dulnith-liyanage/EcoSort_Smart_Bin/assets/ecosort_prototype_hero.jpg

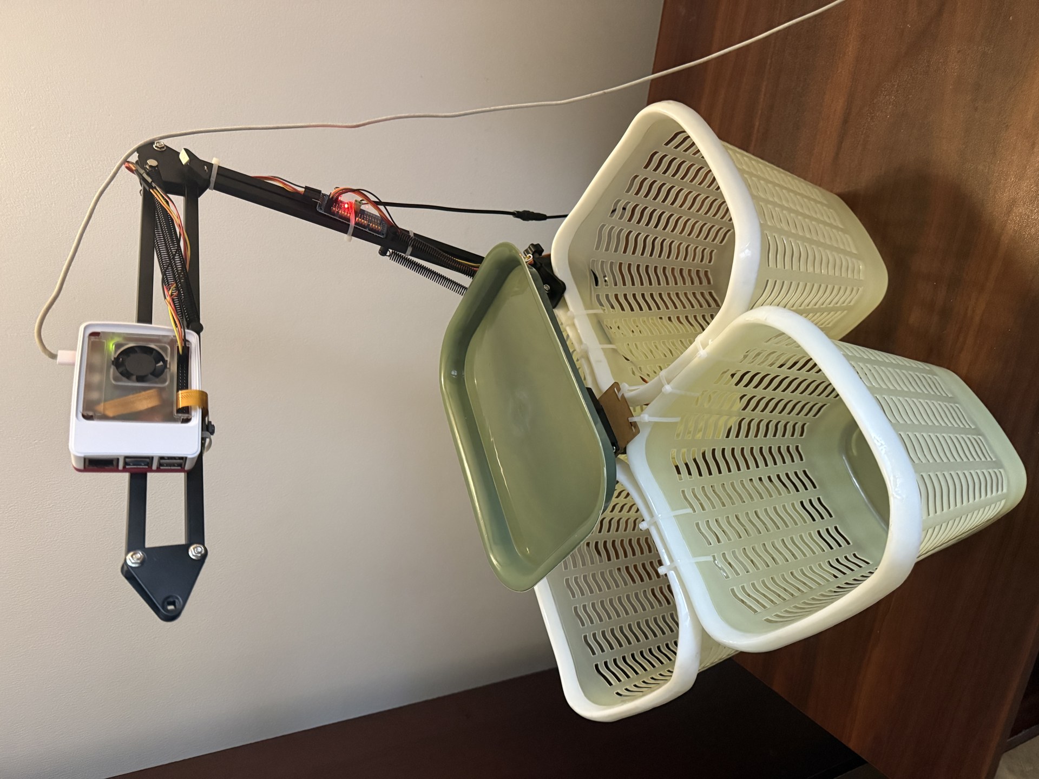
assets/ecosort_prototype_hero.jpg
