dulnith-liyanage/EcoSort_Smart_Bin/images/FMUD5077.jpg

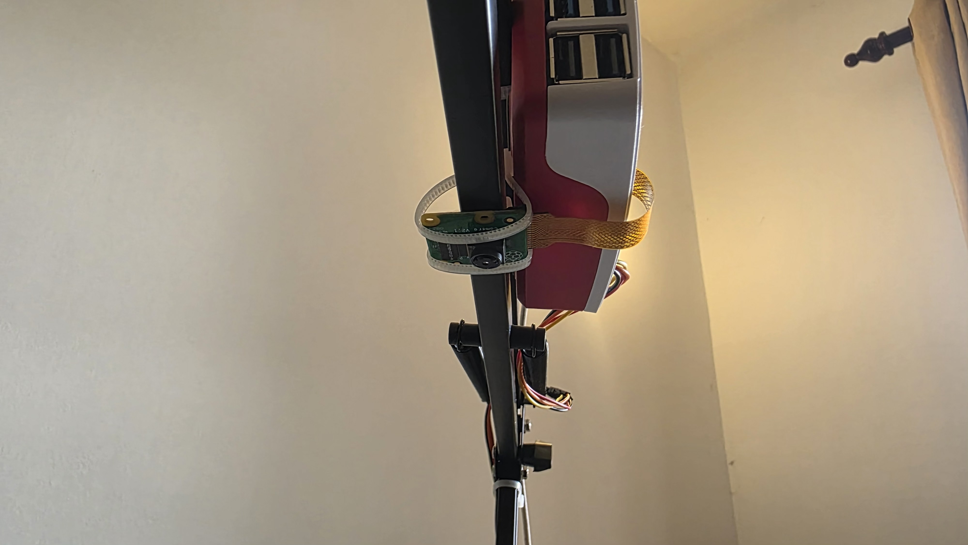
images/FMUD5077.jpg
