dulnith-liyanage/EcoSort_Smart_Bin/hardware/design/output/complete_assembly.step

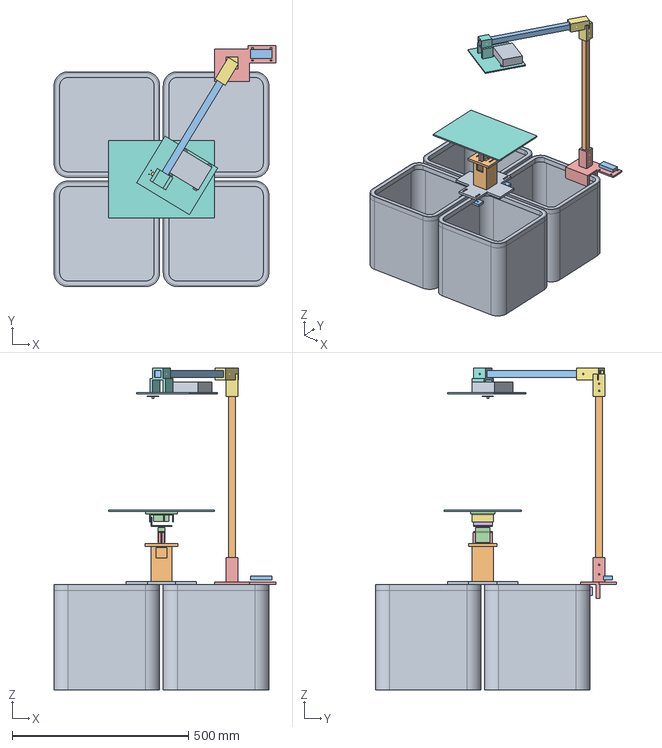
[picture p11: CAD file, 2026-10-23]
hardware/design/output/complete_assembly.step
630.0 x 685.0 x 914.0 mm
