dulnith-liyanage/EcoSort_Smart_Bin/hardware/motor_assembly_only/EcoSort_motor_assembly.step

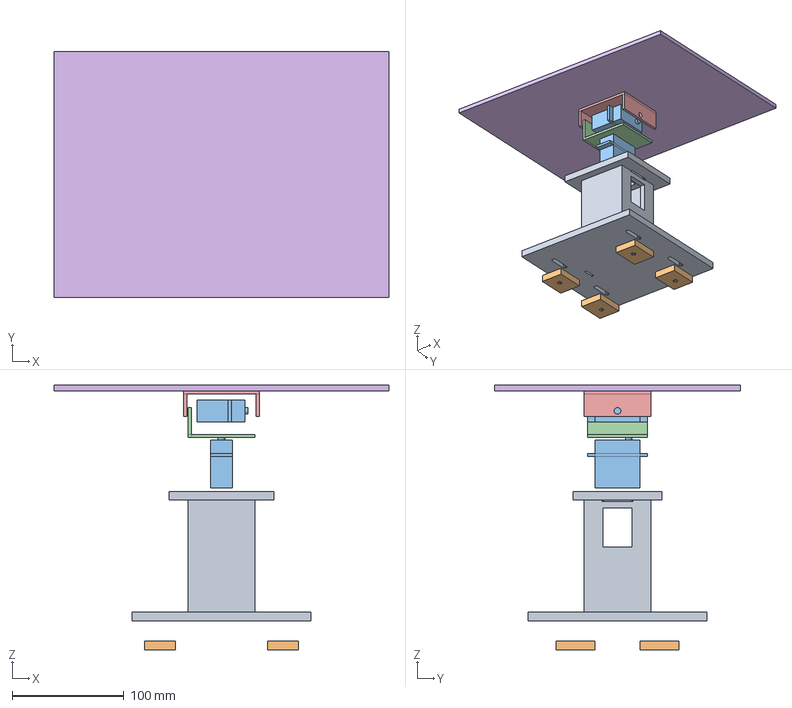
[picture p12: CAD file, 2026-10-20]
hardware/motor_assembly_only/EcoSort_motor_assembly.step
300.0 x 220.0 x 237.0 mm
