dulnith-liyanage/EcoSort_Smart_Bin/hardware/design/output/motor_assembly.step

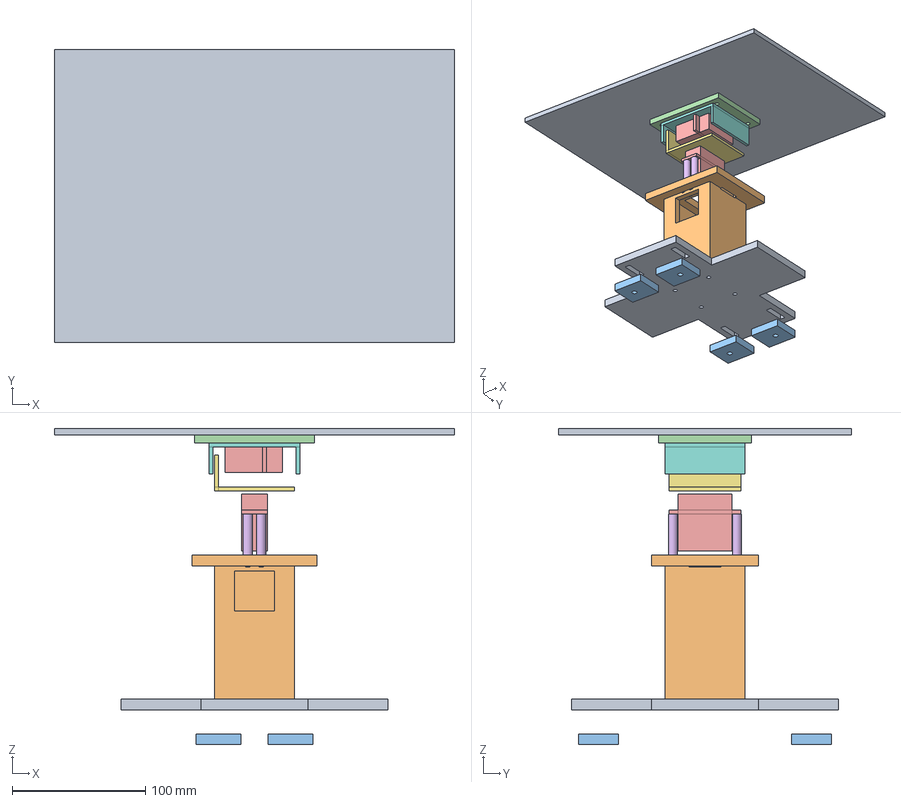
[picture p13: CAD file, 2026-10-23]
hardware/design/output/motor_assembly.step
300.0 x 220.0 x 237.0 mm
