dulnith-liyanage/EcoSort_Smart_Bin/hardware/design/output/step/01_cross_base.step

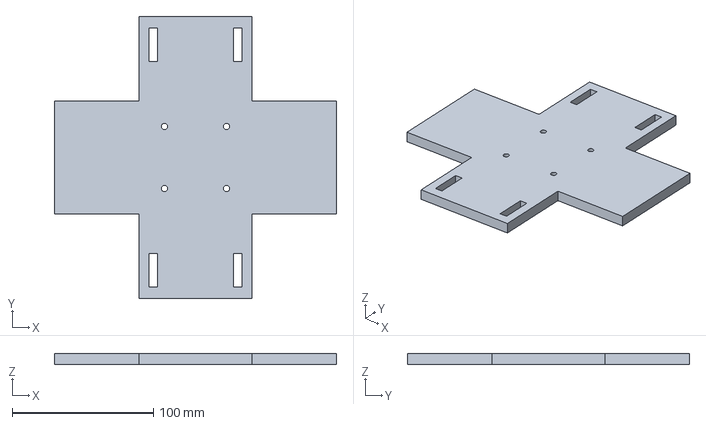
[picture p14: CAD file, 2026-10-23]
hardware/design/output/step/01_cross_base.step
200.0 x 200.0 x 8.00 mm
