dulnith-liyanage/EcoSort_Smart_Bin/hardware/simple_mount_v4/motor_mount.step

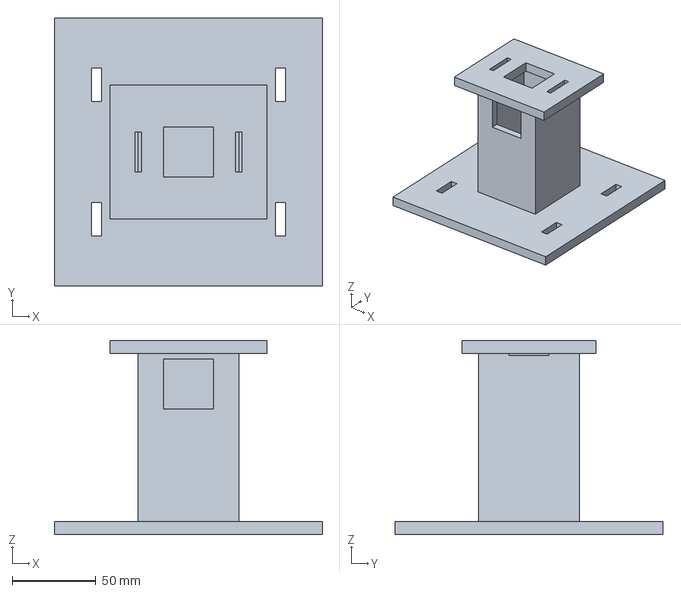
[picture p15: CAD file, 2026-10-20]
hardware/simple_mount_v4/motor_mount.step
160.0 x 160.0 x 116.0 mm
