dulnith-liyanage/EcoSort_Smart_Bin/hardware/design/output/step/07_timber_elbow.step

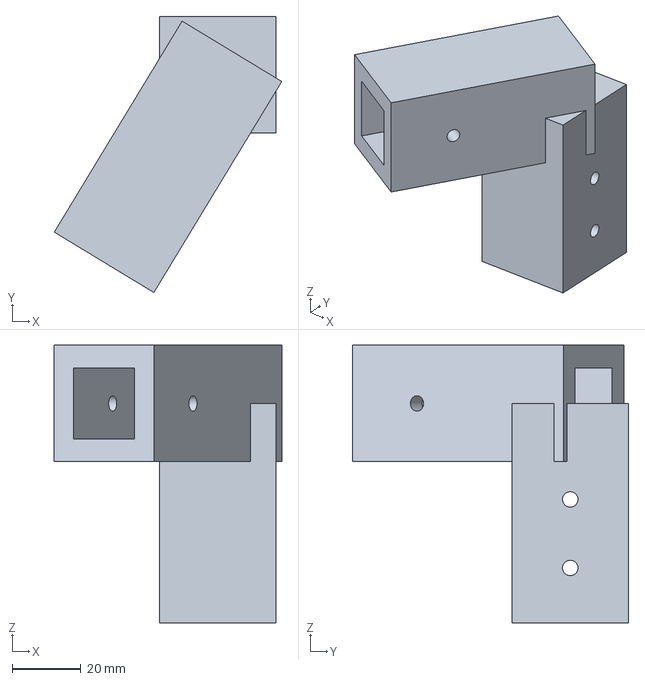
[picture p16: CAD file, 2026-10-23]
hardware/design/output/step/07_timber_elbow.step
66.4 x 80.5 x 81.0 mm
