dulnith-liyanage/EcoSort_Smart_Bin/hardware/simple_mount_v4/optional_rim_shoe.step

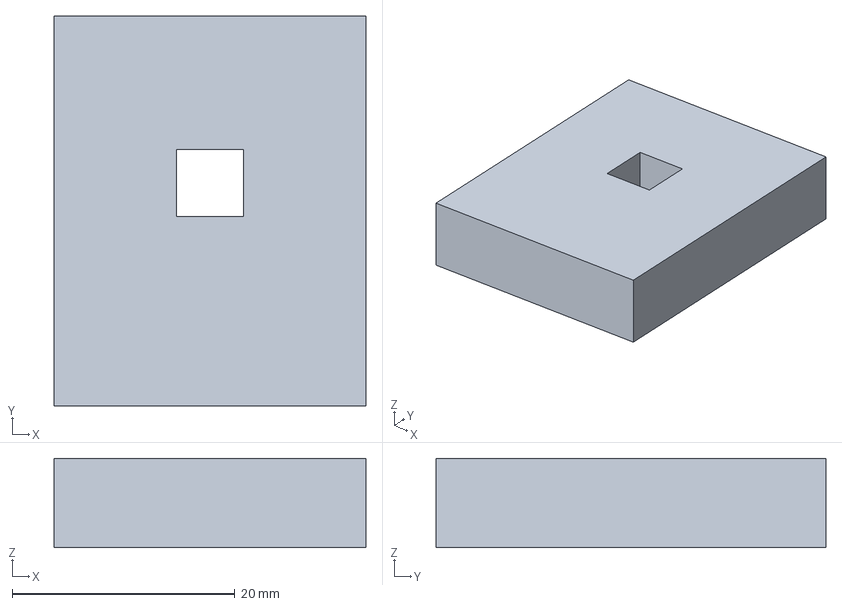
[picture p17: CAD file, 2026-10-20]
hardware/simple_mount_v4/optional_rim_shoe.step
28.0 x 35.0 x 8.00 mm
