dulnith-liyanage/EcoSort_Smart_Bin/hardware/design/output/step/02_motor_pedestal.step

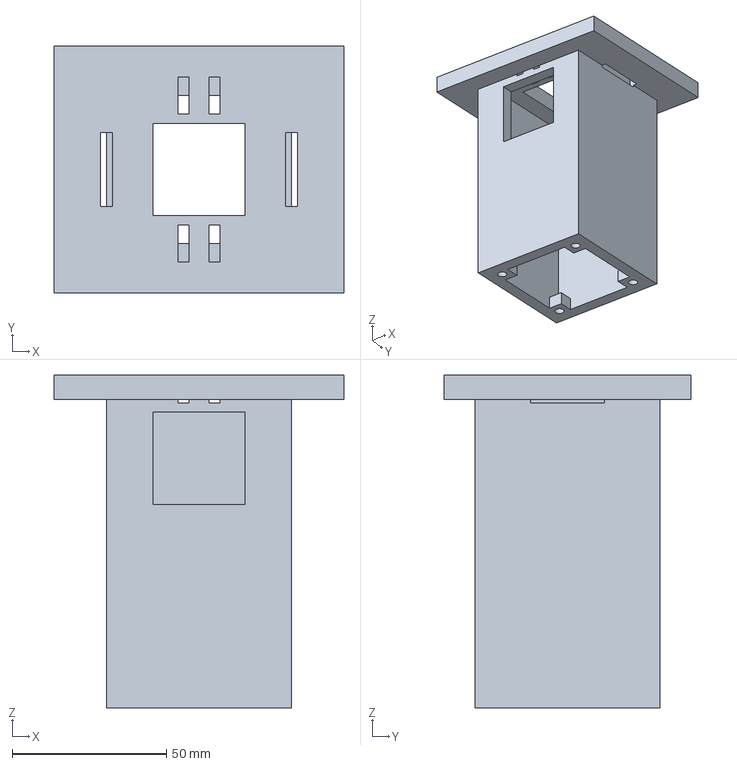
[picture p18: CAD file, 2026-10-23]
hardware/design/output/step/02_motor_pedestal.step
94.0 x 80.0 x 108.0 mm
