dulnith-liyanage/EcoSort_Smart_Bin/hardware/design/output/step/09_rim_and_timber_fit_coupon.step

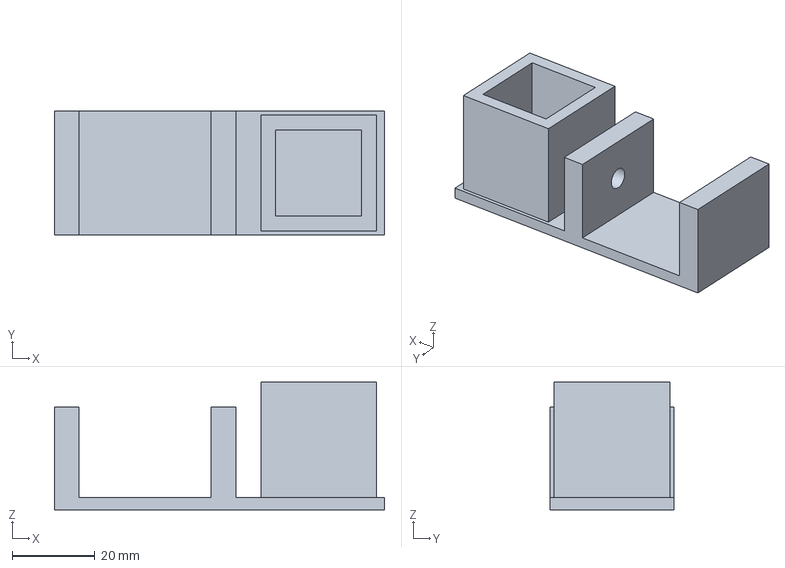
[picture p19: CAD file, 2026-10-23]
hardware/design/output/step/09_rim_and_timber_fit_coupon.step
80.0 x 30.0 x 31.0 mm
