dulnith-liyanage/EcoSort_Smart_Bin/hardware/design/output/step/06_pressure_pad.step

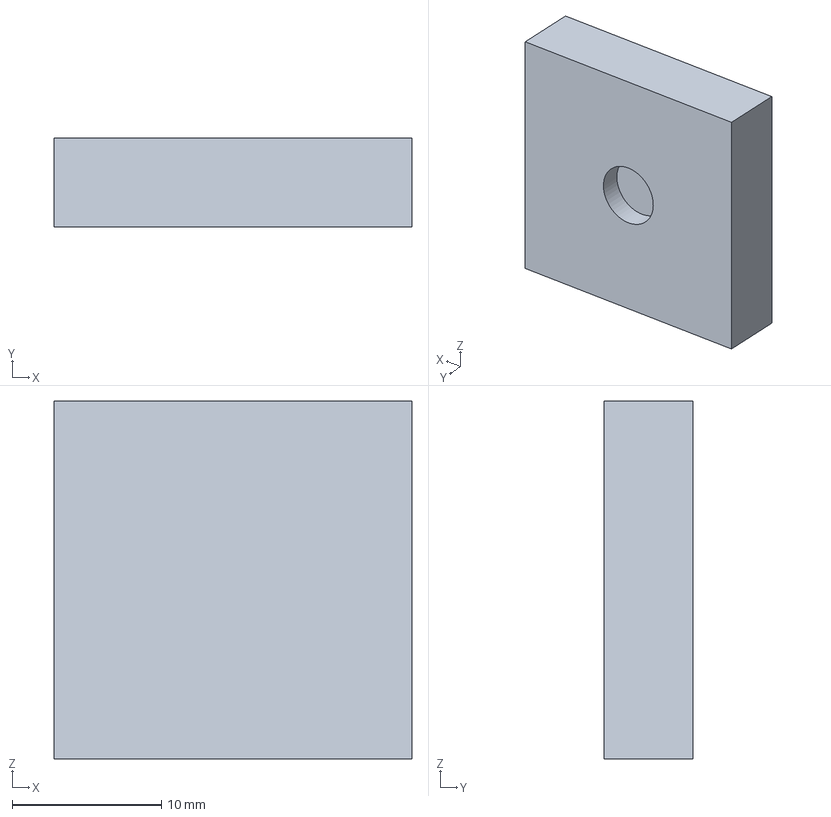
[picture p20: CAD file, 2026-10-23]
hardware/design/output/step/06_pressure_pad.step
24.0 x 6.00 x 24.0 mm
