dulnith-liyanage/EcoSort_Smart_Bin/hardware/design/output/step/08_shared_pi_camera_carrier.step

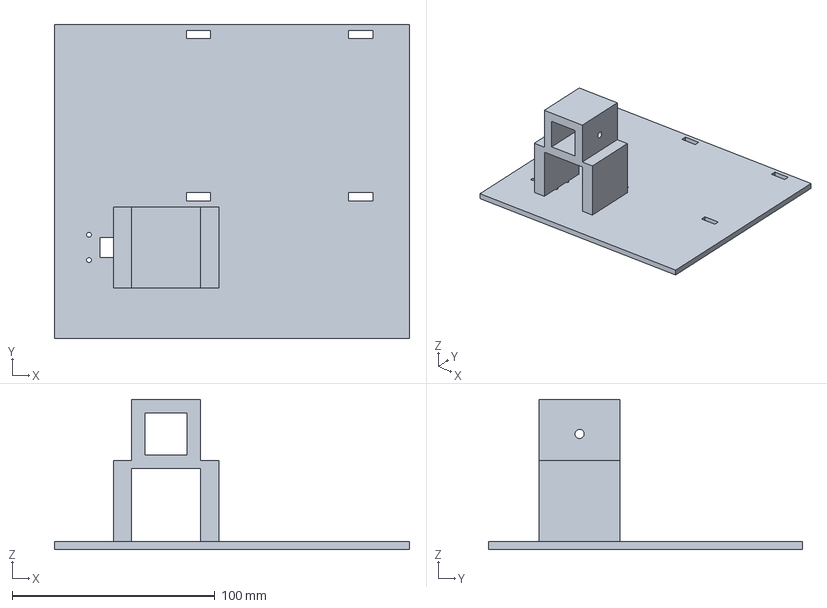
[picture p21: CAD file, 2026-10-23]
hardware/design/output/step/08_shared_pi_camera_carrier.step
175.0 x 155.0 x 74.0 mm
