dulnith-liyanage/EcoSort_Smart_Bin/hardware/design/output/step/04_tray_adapter.step

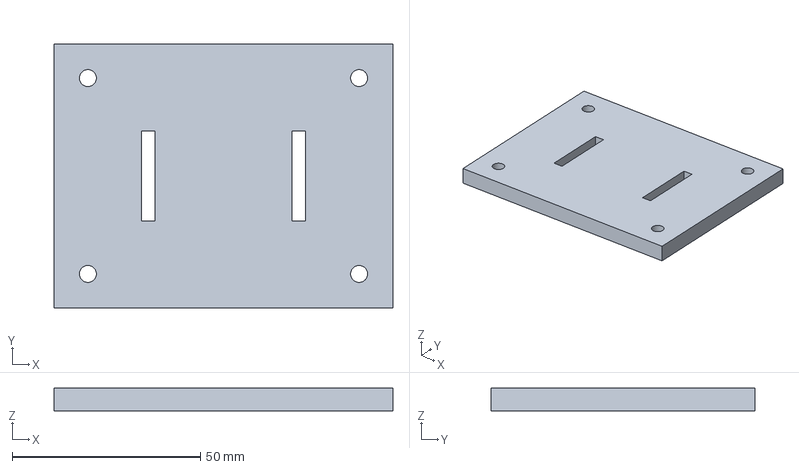
[picture p22: CAD file, 2026-10-23]
hardware/design/output/step/04_tray_adapter.step
90.0 x 70.0 x 6.00 mm
