dulnith-liyanage/EcoSort_Smart_Bin/hardware/design/output/step/05_rear_clip_and_driver_shelf.step

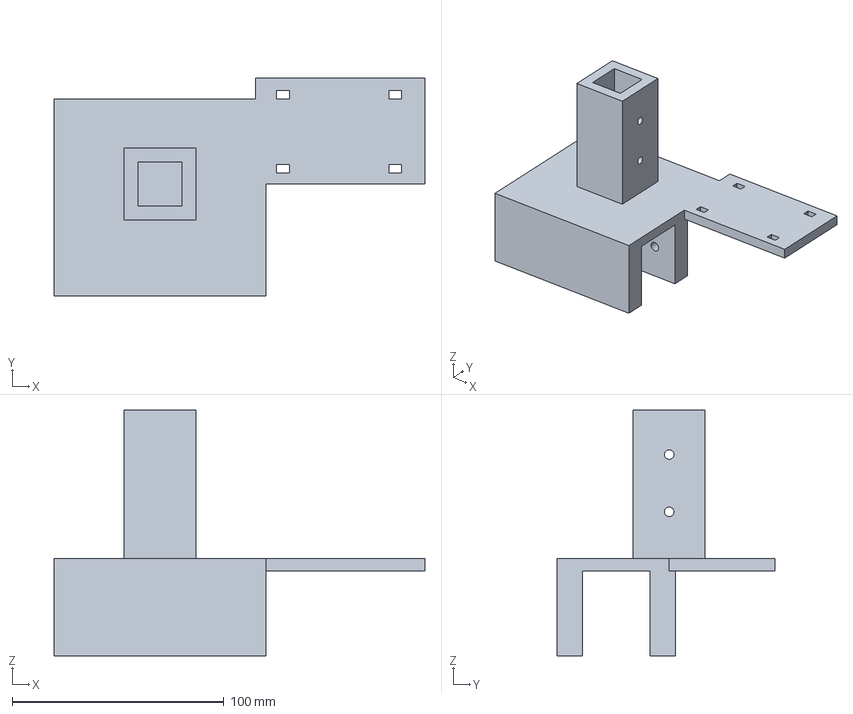
[picture p23: CAD file, 2026-10-23]
hardware/design/output/step/05_rear_clip_and_driver_shelf.step
175.0 x 103.0 x 116.0 mm
