dulnith-liyanage/EcoSort_Smart_Bin/hardware/design/output/step/03_rim_shoe.step

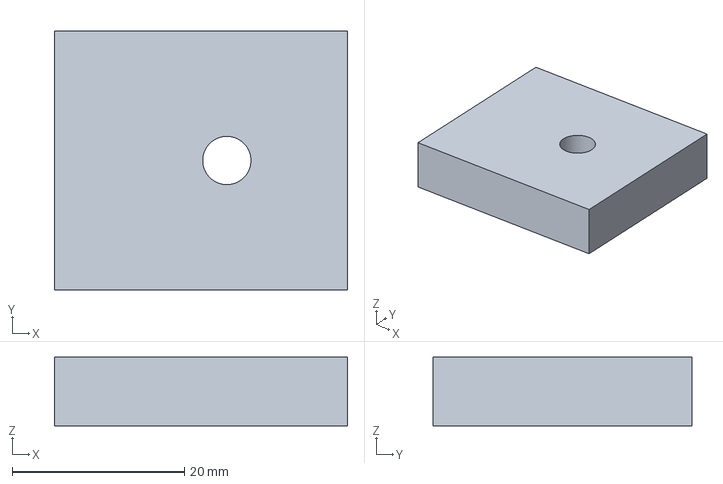
[picture p24: CAD file, 2026-10-23]
hardware/design/output/step/03_rim_shoe.step
34.0 x 30.0 x 8.00 mm
