dulnith-liyanage/EcoSort_Smart_Bin/(list of files, cad)

Other CAD files:
hardware/motor_assembly_only/motor_mount_PRINT.stl
hardware/design/output/complete_assembly.FCStd
hardware/design/output/motor_assembly.FCStd
hardware/design/output/stl/01_cross_base.stl
hardware/design/output/stl/02_motor_pedestal.stl
hardware/design/output/stl/03_rim_shoe.stl
hardware/design/output/stl/04_tray_adapter.stl
hardware/design/output/stl/05_rear_clip_and_driver_shelf.stl
hardware/design/output/stl/06_pressure_pad.stl
hardware/design/output/stl/07_timber_elbow.stl
hardware/design/output/stl/08_shared_pi_camera_carrier.stl
hardware/design/output/stl/09_rim_and_timber_fit_coupon.stl
hardware/simple_mount_v4/motor_mount.stl
hardware/simple_mount_v4/optional_rim_shoe.stl
