dulnith-liyanage/EcoSort_Smart_Bin/assets/prototype_assembly.jpg

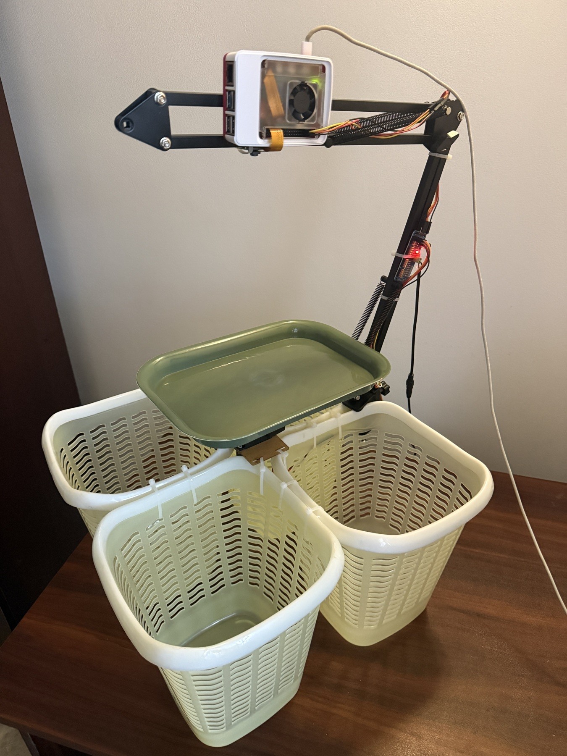
assets/prototype_assembly.jpg
