dulnith-liyanage/EcoSort_Smart_Bin/hardware/design/output/assembly.png

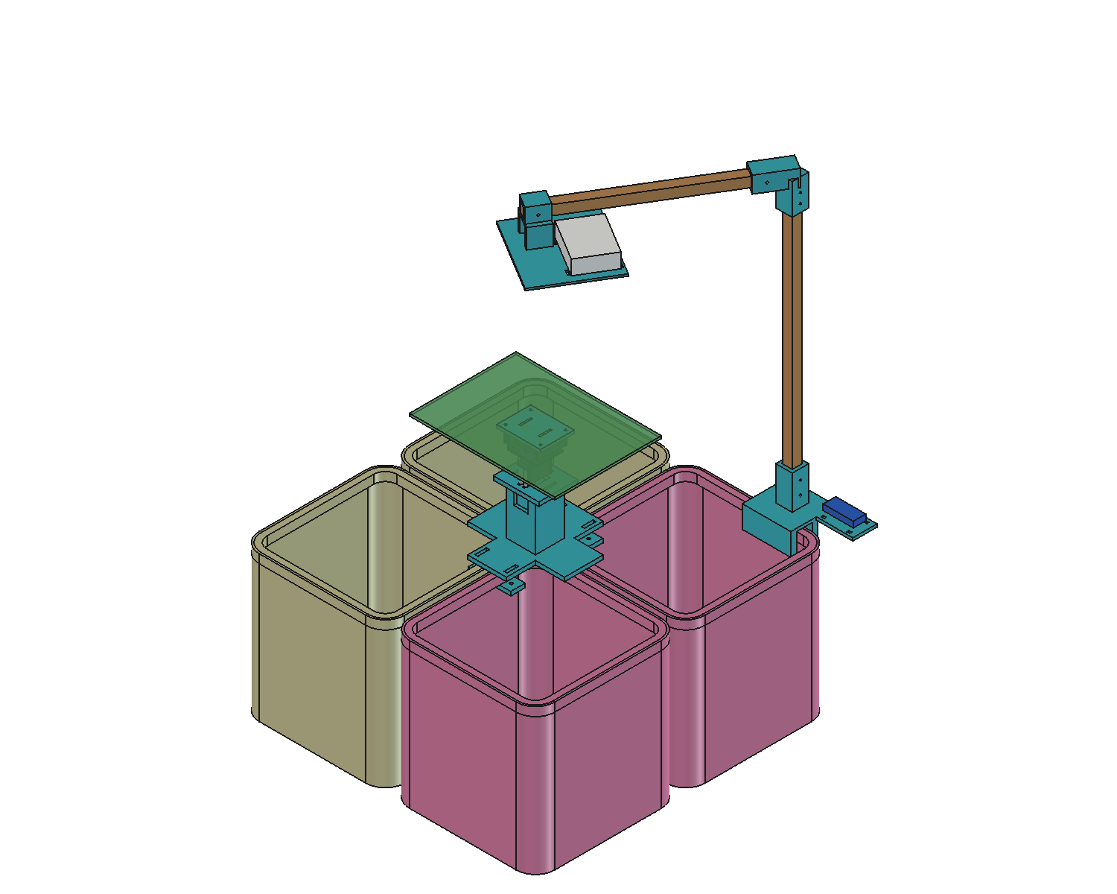
hardware/design/output/assembly.png
