dulnith-liyanage/EcoSort_Smart_Bin/ecosort/hardware/calibration.py

"""
Shared mechanical HOME calibration and smooth trajectory generation.
"""
from dataclasses import dataclass
import json
import math
from pathlib import Path
from ecosort.config import DEFAULT_CALIBRATION_FILE

CONFIG = DEFAULT_CALIBRATION_FILE


@dataclass(frozen=True)
class Calibration:
    pan_home: int = 90
    tilt_home: int = 90
    forward_tilt: int | None = None
    backward_tilt: int | None = None
    shake_degrees: int = 10
    step_delay: float = 0.009
    release_pan_at_home: bool = False
    smooth_motion: bool = False
    dump_hold_seconds: float = 1.0
    release_pan_during_dump: bool = False

    def __post_init__(self):
        if type(self.release_pan_during_dump) is not bool:
            raise ValueError('release_pan_during_dump must be true or false.')
        if (isinstance(self.dump_hold_seconds, bool) or not isinstance(self.dump_hold_seconds, (int, float))
                or not math.isfinite(self.dump_hold_seconds) or not 0.1 <= self.dump_hold_seconds <= 2):
            raise ValueError('dump_hold_seconds must be between 0.1 and 2 seconds.')
        if type(self.smooth_motion) is not bool:
            raise ValueError('smooth_motion must be true or false.')
        if type(self.release_pan_at_home) is not bool:
            raise ValueError('release_pan_at_home must be true or false.')
        for value in (self.pan_home, self.tilt_home):
            if type(value) is not int or not 0 <= value <= 180:
                raise ValueError('HOME angles must be integers between 0 and 180.')
        if (self.forward_tilt is None) != (self.backward_tilt is None):
            raise ValueError('Set both forward_tilt and backward_tilt, or neither.')
        if self.forward_tilt is not None:
            if any(type(v) is not int for v in (self.forward_tilt, self.backward_tilt)):
                raise ValueError('Tilt endpoints must be integer commands.')
            if not 0 <= self.forward_tilt < self.tilt_home < self.backward_tilt <= 180:
                raise ValueError('Tilt endpoints must straddle HOME inside 0..180.')
        if type(self.shake_degrees) is not int or not 0 <= self.shake_degrees <= 10:
            raise ValueError('shake_degrees must be an integer from 0 to 10.')
        if isinstance(self.step_delay, bool) or not isinstance(self.step_delay, (int, float)) or not math.isfinite(self.step_delay) or not 0.005 <= self.step_delay <= 0.2:
            raise ValueError('step_delay must be between 0.005 and 0.2 seconds.')

    @staticmethod
    def _checked(angle):
        if not 0 <= angle <= 180:
            raise ValueError(
                f'Calibrated target {angle} degrees is outside 0..180. '
                'Use measured asymmetric tilt endpoints or re-index the tilt horn; '
                'do not clamp an invalid sorting angle or force the bracket.')
        return angle

    def pan(self, logical_angle):
        return self._checked(logical_angle + self.pan_home - 90)

    def tilt(self, logical_angle):
        if self.forward_tilt is not None:
            if logical_angle < 90:
                angle = self.tilt_home - (90 - logical_angle) * (self.tilt_home - self.forward_tilt) / 55
            else:
                angle = self.tilt_home + (logical_angle - 90) * (self.backward_tilt - self.tilt_home) / 55
            return self._checked(round(angle))
        return self._checked(logical_angle + self.tilt_home - 90)

    def route(self, cfg):
        pan = self.pan(cfg['pan'])
        tilt = self.tilt(cfg['tilt'])
        shake = self._checked(tilt + (-self.shake_degrees if cfg['tilt'] < 90 else self.shake_degrees))
        return pan, tilt, shake

    def validate_routes(self, routes):
        for cfg in routes:
            self.route(cfg)


def load_calibration(path=None):
    # Missing or malformed calibration is an error, not a silent 90-degree reset.
    data = json.loads(Path(path or CONFIG).read_text())
    return Calibration(
        data['pan_home'],
        data['tilt_home'],
        data.get('forward_tilt'),
        data.get('backward_tilt'),
        data.get('shake_degrees', 10),
        data.get('step_delay', 0.009),
        data.get('release_pan_at_home', False),
        data.get('smooth_motion', False),
        data.get('dump_hold_seconds', 1.0),
        data.get('release_pan_during_dump', False),
    )


def motion_steps(start, target, step_delay, smooth=False):
    """Positions/delays for one axis; smooth motion keeps the old peak speed cap.

    The quintic profile starts/ends with zero commanded velocity and acceleration.
    Its peak normalised slope is 1.875, so the longer duration prevents it from
    exceeding the legacy speed of one degree per step_delay. This changes the
    command trajectory, not the physical servo's internal feedback controller.
    """
    for value in (start, target, step_delay):
        if isinstance(value, bool) or not isinstance(value, (int, float)) or not math.isfinite(value):
            raise ValueError('Motion parameters must be finite numbers.')
    if not 0 <= start <= 180 or not 0 <= target <= 180 or step_delay <= 0:
        raise ValueError('Invalid motion range or timing.')
    if start == target:
        return
    if not smooth:
        direction = 1 if target > start else -1
        for angle in range(int(start), int(target) + direction, direction):
            yield angle, step_delay
        return
    duration = max(0.20, 1.875 * abs(target - start) * step_delay)
    intervals = math.ceil(duration / 0.02)
    delay = duration / intervals
    for index in range(1, intervals + 1):
        t = index / intervals
        fraction = t * t * t * (10 + t * (-15 + 6 * t))
        angle = target if index == intervals else start + (target - start) * fraction
        yield angle, delay
