dulnith-liyanage/EcoSort_Smart_Bin/(commit log)

2026-09-02 feat: Enhance object detection feedback with locking mechanism and frame tracking
2026-09-09 chore: update gitignore to track keras model and exclude dataset directory
2026-09-09 feat: implement background subtraction for motion-based object detection and adaptive tray calibration
2026-09-11 feat: add Arduino dual servo controller and update live vision script for hardware integration
2026-09-13 refactor: replace TensorFlow model with Hugging Face zero-shot CLIP classifier
    [live_smart_bin.py]
2026-09-17 feat: add direct Raspberry Pi I2C PCA9685 hardware support and setup script
2026-09-17 fix: pre-load OpenBLAS library on Linux ARM64 and add necessary system dependencies
    [live_smart_bin.py]
2026-09-17 Fix PyTorch undefined symbol sbgemm_ by linking Debian openblas-pthread
    [live_smart_bin.py]
2026-09-17 Add standalone 2-axis servo bracket controller program for Raspberry Pi
2026-09-17 Support native Picamera2 for CSI camera on CAM0
2026-09-17 Add camera diagnostic utility for Pi 5 CAM0/CAM1
2026-09-18 Configure 2x2 grid Pan-Tilt kinematics (center-mounted) and remove Arduino sketches
2026-10-20 Add cleaned motor assembly and standalone printable mounts
2026-10-23 Complete four-bin mount design and verify offline runtime fixes
2026-10-23 Finalize main-branch cleanup and guard saved CAD completeness
2026-10-26 Calibrate level HOME and guard unreachable pan-tilt routes
2026-10-26 Prevent competing processes from commanding the servo driver
2026-10-26 Add motor-free VNC camera preview and desktop launcher
2026-10-26 Add persistent power-loss diagnostic workflow and motor-free inference check
2026-10-26 Narrow waste classes, reject uncertain predictions and remove obsolete CAD
2026-10-26 Release cached-label text encoder and record pretrained backend smoke checks
2026-10-27 Update assembly docs with separate motor power fix
2026-10-27 Add local EcoSort dashboard with camera telemetry and supervised routing controls
2026-10-28 Ease servo acceleration and deceleration during sorting
2026-10-28 Add route image reviews and material estimates; extend dump pause and quiet repeated HOME
2026-10-28 Add hardware assembly photos to root directory
2026-10-28 Link hardware photos in assembly documentation
2026-11-01 refactor: modularize codebase into ecosort package, add project assets, and overhaul README
    - Restructure monolithic scripts into the modular 'ecosort' package (config, logging, compat, hardware, vision, core)
    - Eliminate over 1,600 lines of duplicate code, repeated ANSI loggers, and redundant bin definitions
    - Preserve 100% backward-compatible root CLI entry points (live_smart_bin, servo_control, check_camera, servo_settings)
    - Add 8 optimized visual assets (architecture diagram, hardware photos, prototype hero, dashboard UI, and sorting demos)
    - Comprehensively overhaul README with badges, embedded visuals, Mermaid pipeline flowchart, 2x2 sorting matrix, hardware BOM, quickstart guide, and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
