dulnith-liyanage/EcoSort_Smart_Bin/(notices)

Notices in the files:
README.md:
License: MIT
