dulnith-liyanage/EcoSort_Smart_Bin/images/IMG_9714.JPG

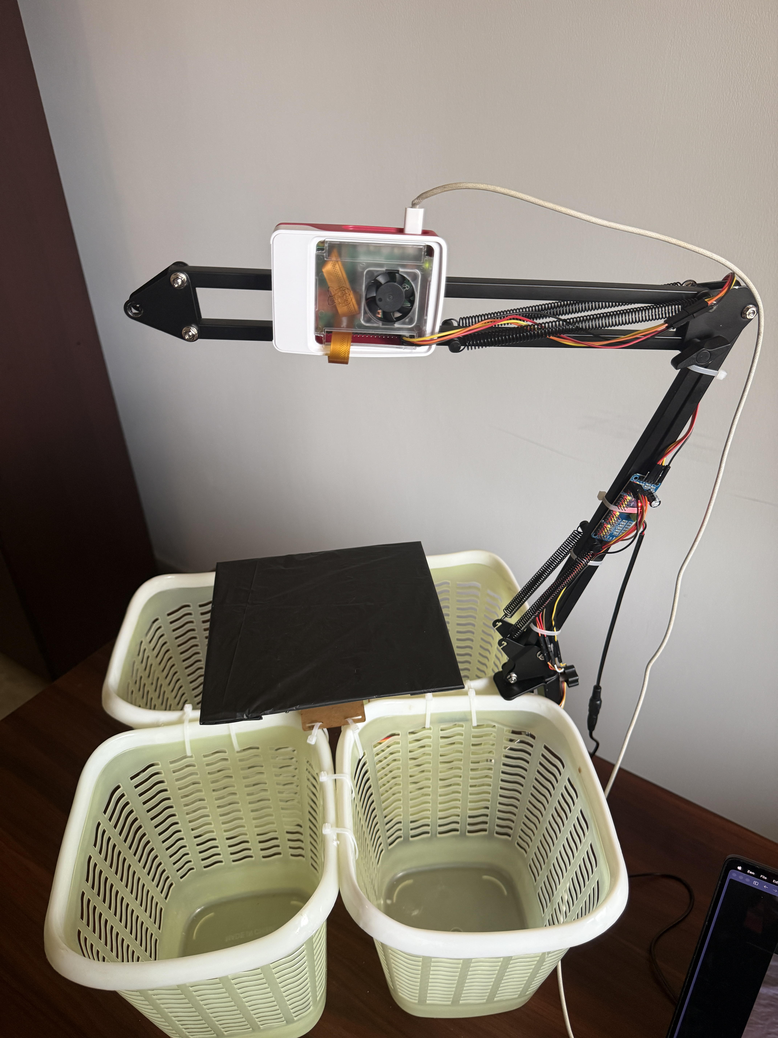
images/IMG_9714.JPG
